dimitdim/AsyncFinal/README.md

# AsyncFinal
Asynchronous VLSI SP2017: Final Project

Please use Harness.asc to run tests
