dimitdim/AsyncFinal/GasP.png

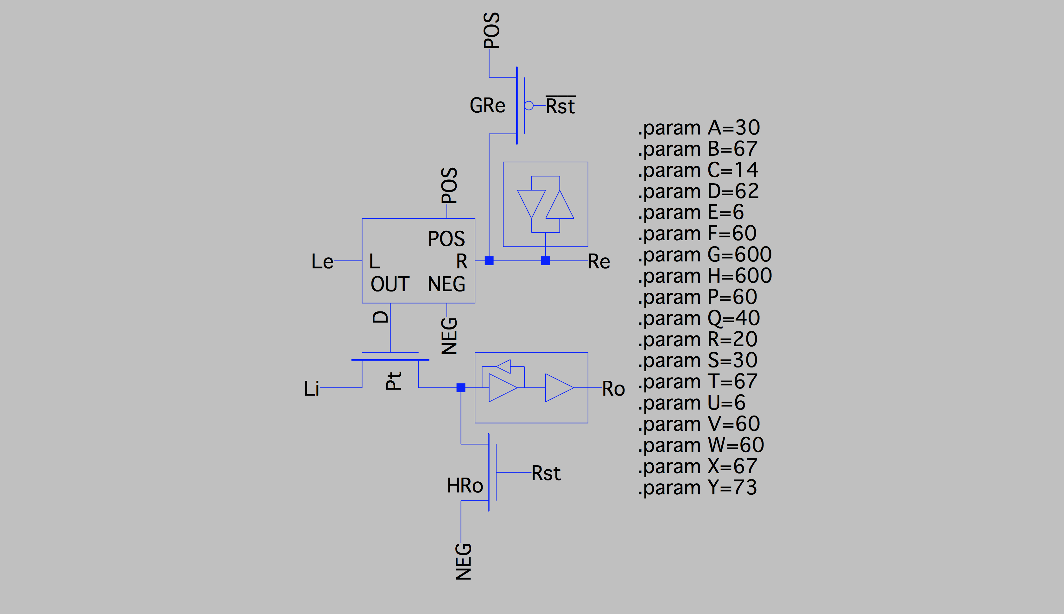
GasP.png
