dimitdim/AsyncFinal/GasPCtrl.png

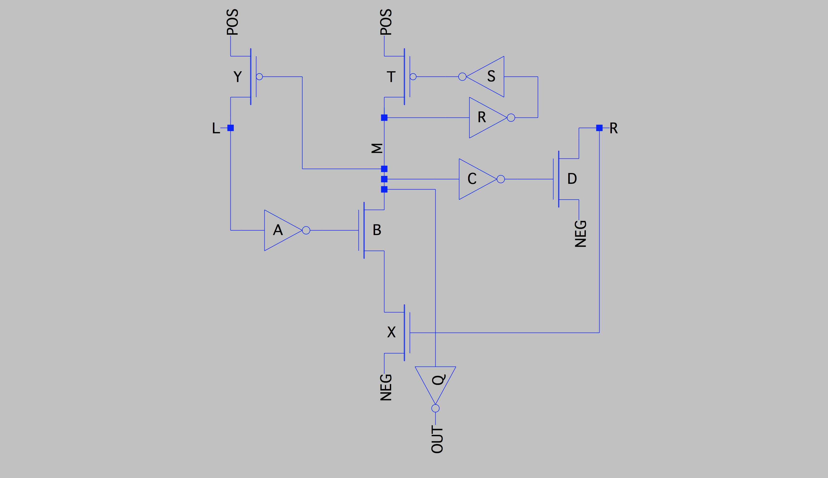
GasPCtrl.png
