dimitdim/AsyncFinal/GasPPower.png

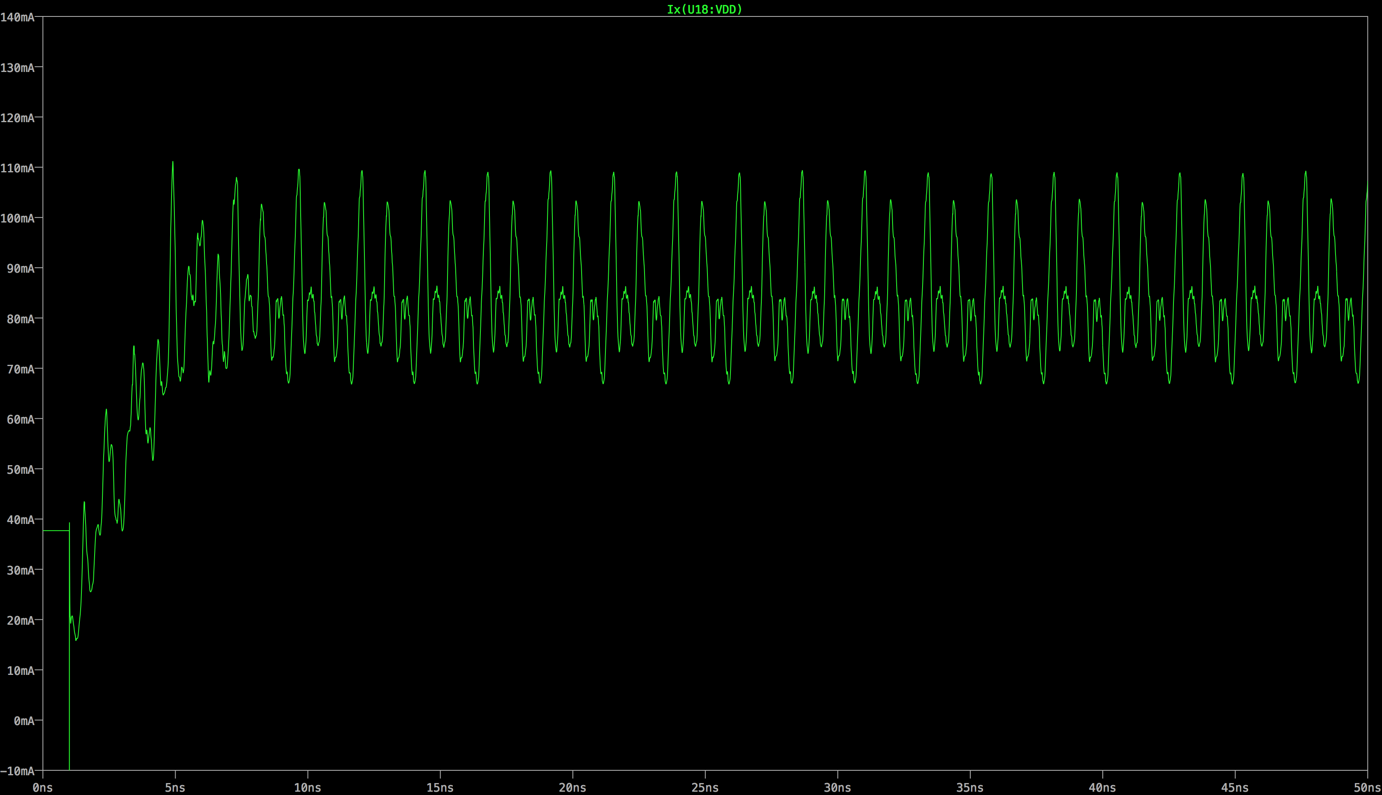
GasPPower.png
