dimitdim/AsyncFinal/STFB.png

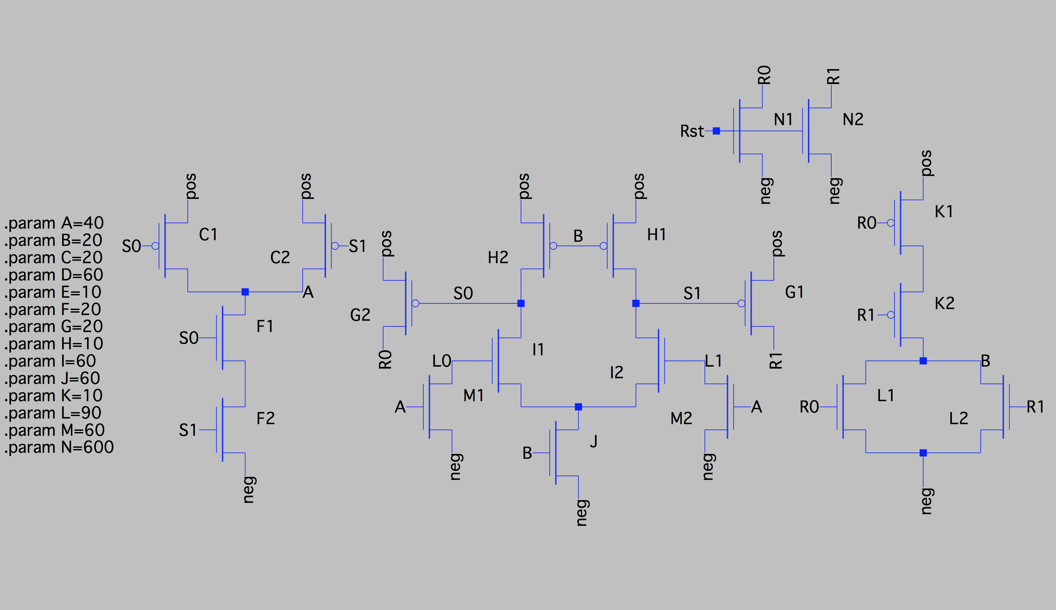
STFB.png
