dimitdim/AsyncFinal/STFBPower.png

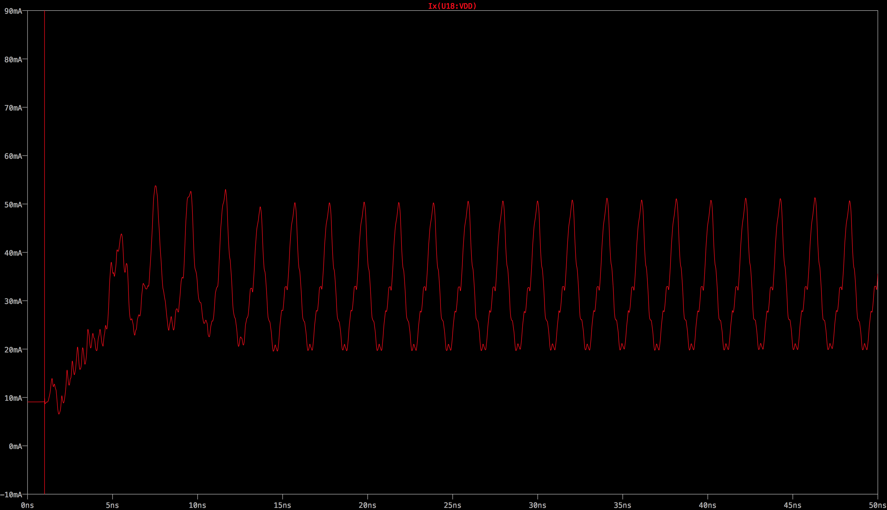
STFBPower.png
