dimitdim/AsyncFinal/STFBSink.png

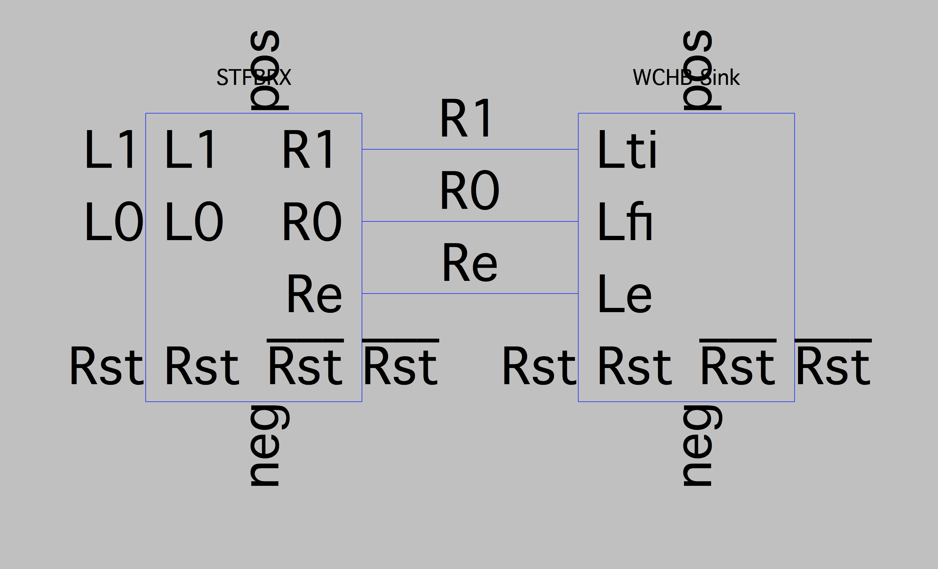
STFBSink.png
