dimitdim/AsyncFinal/STFBSource.png

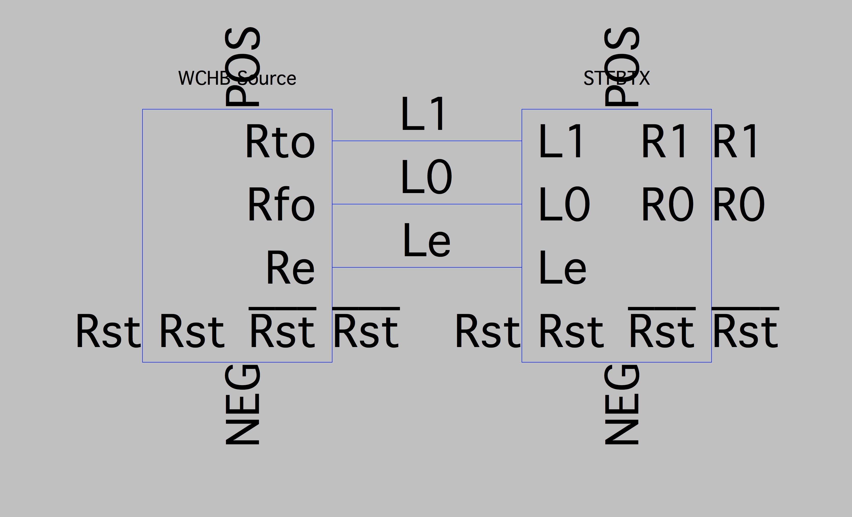
STFBSource.png
