dimitdim/AsyncFinal/WCHBPower.png

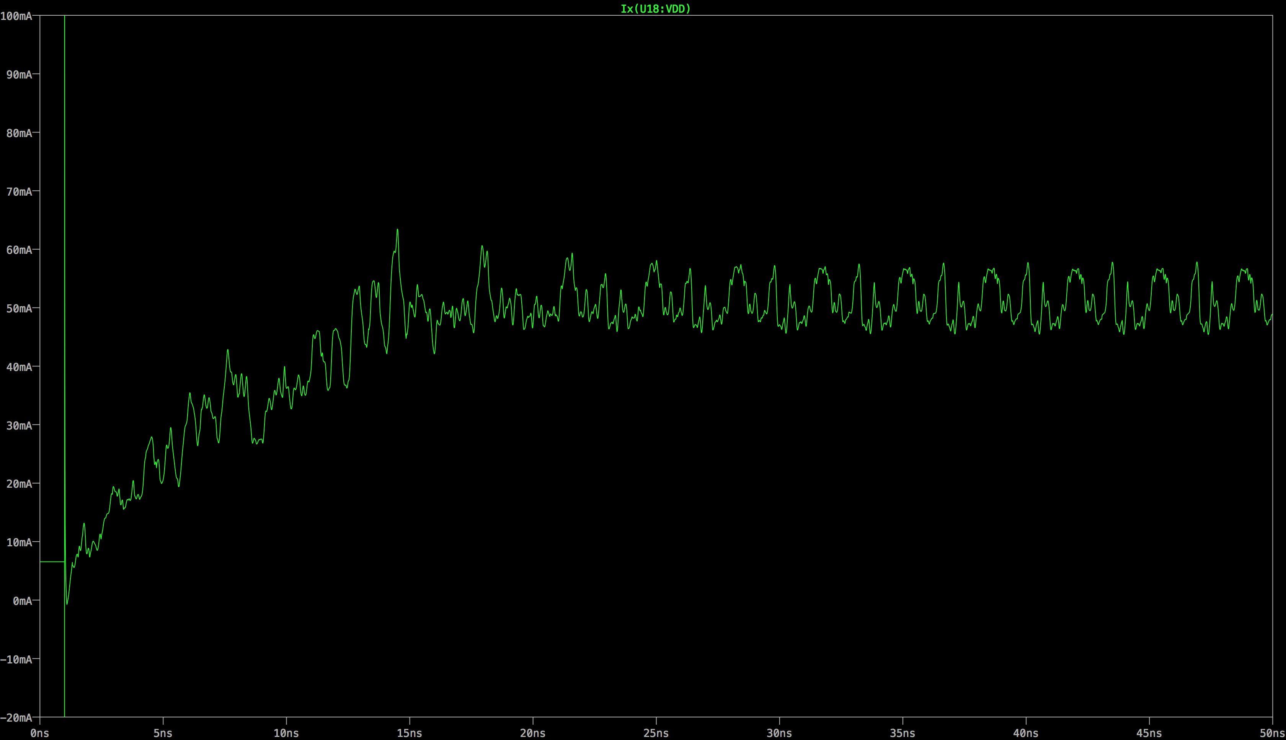
WCHBPower.png
