dimitdim/AsyncFinal/WCHBSource.png

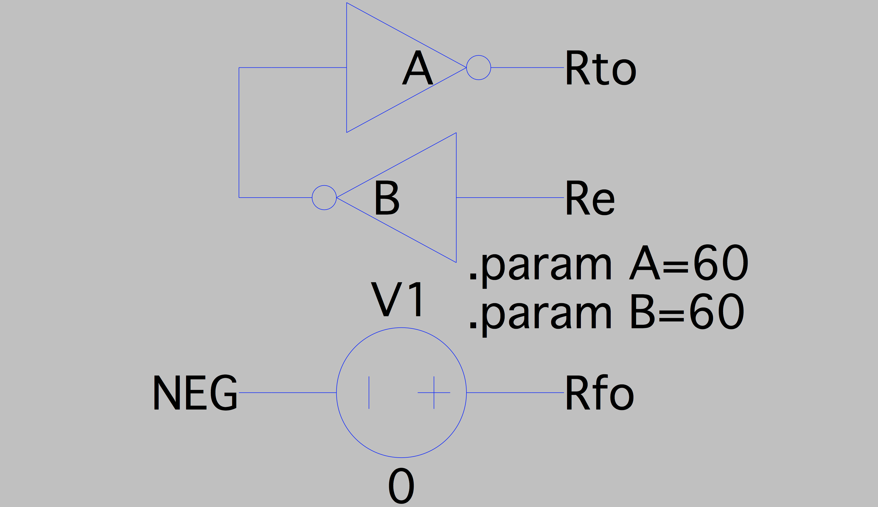
WCHBSource.png
