dimitdim/AsyncFinal/GasP.asc

GRe: pmos3; W={G}
HRo: nmos3; W={H}
Pt: nmos3; W={P}
X16: Stat; E={E} F={F}
X34: Latch; U={U} V={V} W={W}
X49: GasPCtrl; A={A} B={B} C={C} D={D} Q={Q} R={R} S={S} T={T} X={X} Y={Y} Vdd={Vdd}
Named nets: Ro, Re, Li, Le, _Rst, POS, D, NEG, Rst
.param A=30
.param B=67
.param C=14
.param D=62
.param E=6
.param F=60
.param P=60
.param Q=40
.param R=20
.param S=30
.param T=67
.param X=67
.param Y=73
.param U=6
.param V=60
.param W=60
.param H=600
.param G=600
