dimitdim/AsyncFinal/GasPCtrl.asc

A: inverter; W={A}
B: nmos3; W={B}
C: inverter; W={C}
D: nmos3; W={D}
Q: inverter; W={Q}
R: inverter; W={R}
S: inverter; W={S}
T: pmos3; W={T}
X: nmos3; W={X}
Y: pmos3; W={Y}
Named nets: NEG, POS, L, R, OUT, M
