dimitdim/AsyncFinal/GasPHarness.asc

U1: gnd
U2: gnd
U3: gnd
U4: gnd
U5: gnd
U6: gnd
U7: gnd
U8: gnd
U9: gnd
U10: gnd
U11: vdd
U12: vdd
U13: vdd
U14: vdd
U15: vdd
U16: vdd
U17: gnd
U18: vdd
U19: vdd
U20: vdd
U21: vdd
U22: vdd
U23: gnd
U24: gnd
V1: vsource; {Vdd}
V2: vsource; PWL(0 {Vdd} {Trst-Ts} {Vdd} {Trst} 0)
V3: vsource; PWL(0 0 {Trst-Ts} 0 {Trst} {Vdd})
X1: GasP
X2: GasP
X3: GasP
X4: GasP
X5: GasP
X6: GasP
X7: GasP
X8: GasP
X9: GasPSink
X10: GasPSource
Named nets: Rst, _Rst
.param Vdd=5
.inc main.sub
.tran {Tm}
.param Tm=50n Trst=1n Ts=1p
