dimitdim/AsyncFinal/GasPSink.asc

A1: inverter; W={A}
B1: nmos3; W={B}
C1: inverter; W={C}
D1: nmos3; W={D}
GRe: pmos3; W={G}
HRto: nmos3; W={H}
Pt: nmos3; W={P}
Q1: inverter; W={Q}
R1: inverter; W={R}
S1: inverter; W={S}
T1: pmos3; W={T}
X1: nmos3; W={X}
X16: Stat; E={E} F={F}
X34: Latch; U={U} V={V} W={W}
Y1: pmos3; W={Y}
Named nets: Li, _Rst, POS, D, NEG, Rst, M, Le
.param A=30
.param B=67
.param C=14
.param D=62
.param E=6
.param F=60
.param P=60
.param Q=40
.param R=20
.param S=30
.param T=67
.param X=67
.param Y=73
.param U=6
.param V=60
.param W=60
.param H=600
.param G=600
