dimitdim/AsyncFinal/GasPSource.asc

A: inverter; W={A}
B: nmos3; W={B}
C: inverter; W={C}
D: nmos3; W={D}
GRe: nmos3; W={G}
HRo: pmos3; W={H}
I: inverter; W={I}
J: inverter; W={J}
P: nmos3; W={P}
Q: inverter; W={Q}
R: inverter; W={R}
S: inverter; W={S}
T: pmos3; W={T}
X2: Latch; U={U} V={V} W={W}
X3: Stat; E={E} F={F}
X: nmos3; W={X}
Y: pmos3; W={Y}
Z: inverter; W={Z}
Named nets: Ro, Re, _Rst, POS, NEG, Rst, M
.param A=41
.param B=93
.param C=17
.param D=75
.param E=6
.param F=60
.param P=60
.param Q=67
.param R=28
.param S=41
.param T=93
.param X=93
.param Y=90
.param U=6
.param V=60
.param W=180
.param H=600
.param Z=480
.param G=600
.param I=60
.param J=40
