dimitdim/AsyncFinal/Harness.asc

U2: gnd
U3: gnd
U4: gnd
U5: gnd
U6: gnd
U7: gnd
U8: gnd
U9: gnd
U10: gnd
U17: gnd
U22: gnd
U23: gnd
U24: gnd
U25: gnd
U36: gnd
U37: gnd
U38: gnd
U39: gnd
U40: gnd
U41: gnd
U42: gnd
U43: gnd
U44: gnd
U53: gnd
U54: gnd
U55: gnd
U56: gnd
U57: gnd
U58: gnd
U59: gnd
U60: gnd
U61: WCHB
U62: WCHB
U63: WCHB
U64: WCHB
U65: WCHB
U66: WCHB
U67: WCHB
U68: WCHB
U70: gnd
U72: gnd
U73: gnd
U74: gnd
U75: gnd
U76: vdd
V1: vsource; {Vdd}
V2: vsource; {Vdd}
V3: vsource; {Vdd}
V4: vsource; PWL(0 {Vdd} {Trst-Ts} {Vdd} {Trst} 0)
V5: vsource; PWL(0 0 {Trst-Ts} 0 {Trst} {Vdd})
V6: vsource; {Vdd}
X1: STFBSource
X2: STFBSink
X3: STFB
X4: STFB
X5: STFB
X6: STFB
X7: STFB
X8: STFB
X9: STFB
X10: STFB
X11: GasP
X12: GasPSink
X13: GasPSource
X14: GasP
X15: GasP
X16: GasP
X17: GasP
X18: GasP
X19: GasP
X20: GasP
X21: WCHBSink
X22: WCHBSource
Named nets: Rst, _Rst, Vs, Vg, Vw
.param Vdd=5
.inc main.sub
.tran {Tm}
.param Tm=50n Trst=1n Ts=1p
