dimitdim/AsyncFinal/Latch.asc

U: inverter; W={U}
V: inverter; W={V}
W: inverter; W={W}
Named nets: IN, OUT
