dimitdim/AsyncFinal/Stat.asc

E: inverter; W={E}
F: inverter; W={F}
Named nets: S
