dimitdim/AsyncFinal/STFB.asc

C1: pmos3; W={C}
C2: pmos3; W={C}
F1: nmos3; W={F}
F2: nmos3; W = {F}
G1: pmos3; W={G}
G2: pmos3; W={G}
H1: pmos3; W={H}
H2: pmos3; W={H}
I1: nmos3; W={I}
I2: nmos3; W={I}
J: nmos3; W={J}
K1: pmos3; W={K}
K2: pmos3; W={K}
L1: nmos3; W={L}
L2: nmos3; W={L}
M1: nmos3; W={M}
M2: nmos3; W={M}
N1: nmos3; W={N}
N2: nmos3; W={N}
Named nets: A, neg, S0, S1, pos, R0, R1, B, L0, L1, Rst
.param A=40
.param B=20
.param C=20
.param D=60
.param E=10
.param F=20
.param G=20
.param H=10
.param I=60
.param J=60
.param K=10
.param L=90
.param M=60
.param N=600
