dimitdim/AsyncFinal/STFBRX.asc

G1: inverter; W={G}
G2: inverter; W={G}
H1: pmos3; W={H}
H2: pmos3; W={H}
I1: nmos3; W={I}
I2: nmos3; W={I}
J1: nmos3; W={J}
K1: pmos3; W={K}
K2: pmos3; W={K}
L1: nmos3; W={L}
L2: nmos3; W={L}
M1: nmos3; W={M}
M2: nmos3; W={M}
N1: inverter; W={100*N}
N2: inverter; W={10*N}
N3: inverter; W={N}
N4: nmos3; W={N}
N5: nmos3; W={N}
Named nets: Re, pos, neg, B, L0, L1, S0, S1, R0, R1, Rst
.param A=40
.param B=20
.param C=20
.param D=60
.param E=10
.param F=20
.param G=20
.param H=10
.param I=60
.param J=60
.param K=10
.param L=90
.param M=60
.param N=60
