dimitdim/AsyncFinal/STFBSink.asc

X1: WCHBSink
X2: STFBRX
Named nets: Re, R0, R1, Rst, _Rst, neg, pos, L1, L0
