dimitdim/AsyncFinal/STFBSource.asc

X1: WCHBSource
X2: STFBTX
Named nets: NEG, Rst, _Rst, L1, L0, Le, POS, R1, R0
