dimitdim/AsyncFinal/STFBTX.asc

A1: pmos3; W={A}
A2: pmos3; W={A}
B1: nmos3; W={B}
B2: nmos3; W={B}
C1: pmos3; W={C}
C2: pmos3; W={C}
D: inverter; W={D}
E: inverter; W={E}
F: nmos3; W={F}
G1: pmos3; W={G}
G2: pmos3; W={G}
H1: pmos3; W={H}
H2: pmos3; W={H}
I1: nmos3; W={I}
I2: nmos3; W={I}
J1: nmos3; W=J
J2: nmos3; W={J}
K1: pmos3; W={K}
K2: pmos3; W={K}
L1: nmos3; W={L}
L2: nmos3; W={L}
N1: nmos3; W={N}
N2: nmos3; W={N}
Named nets: B, L0, L1, R0, R1, S0, S1, pos, neg, A, Le, POS, NEG, Rst
.param A=40
.param B=20
.param C=20
.param D=60
.param E=10
.param F=10
.param G=20
.param H=10
.param I=60
.param J=120
.param K=10
.param L=90
.param N=600
