dimitdim/AsyncFinal/WCHB.asc

Af1: cel; W={A}
Af: cel; W={A}
At1: cel; W={A}
At: cel; W={A}
B1: nand; W={B}
B: nand; W={B}
C1: inverter; W={C}
C: inverter; W={C}
Df1: inverter; W={D}
Df: inverter; W={D}
Dt1: inverter; W={D}
Dt: inverter; W={D}
Gf1: pmos3; W={G}
Gf: pmos3; W={G}
Gt1: pmos3; W={G}
Gt: pmos3; W={G}
X1: Stat; E={E} F={F}
X2: Stat; E={E} F={F}
X3: Stat; E={E} F={F}
X4: Stat; E={E} F={F}
Named nets: Lti, Lfi, Le, St, Sf, _Rst, POS, Rto, Rfo, Re, St1, Sf1, Mt, Mf, Me
.param A=60
.param B=60
.param C=60
.param D=60
.param E=6
.param F=60
.param G=600
