dimitdim/AsyncFinal/WCHBHarness.asc

U1: vdd
U2: gnd
U3: gnd
U4: gnd
U5: gnd
U6: gnd
U7: gnd
U8: gnd
U9: gnd
U10: gnd
U11: vdd
U12: vdd
U13: vdd
U14: vdd
U15: vdd
U16: vdd
U17: gnd
U18: vdd
U19: vdd
U20: vdd
U21: vdd
U22: gnd
U23: gnd
U24: WCHB
U25: gnd
U26: WCHB
U27: WCHB
U28: WCHB
U29: WCHB
U30: WCHB
U31: WCHB
U32: WCHB
V1: vsource; {Vdd}
V2: vsource; PWL(0 {Vdd} {Trst-Ts} {Vdd} {Trst} 0)
V3: vsource; PWL(0 0 {Trst-Ts} 0 {Trst} {Vdd})
X1: WCHBSink
X2: WCHBSource
Named nets: Rst, _Rst
.param Vdd=5
.inc main.sub
.tran {Tm}
.param Tm=50n Trst=1n Ts=1p
