dimitdim/AsyncFinal/WCHBSink.asc

A: nor; W={A}
Named nets: Lti, Lfi, Le
.param A=60
