dimitdim/AsyncFinal/WCHBSource.asc

A: inverter; W={A}
B: inverter; W={B}
V1: vsource; 0
Named nets: Rto, Re, Rfo, NEG
.param A=60
.param B=60
